fmfi-svt-deadlock/obsolete/README.md

# PROJECT MOVED

This repository is now hosted here: https://gitlab.com/project-deadlock/obsolete/obsolete-embedded-components

Cementery of obsolete components
================================

May they rest in peace.
