fmfi-svt-deadlock/obsolete/reader-hw/reader.brd

## EAGLE design reader-hw/reader.brd (2015-03-18)

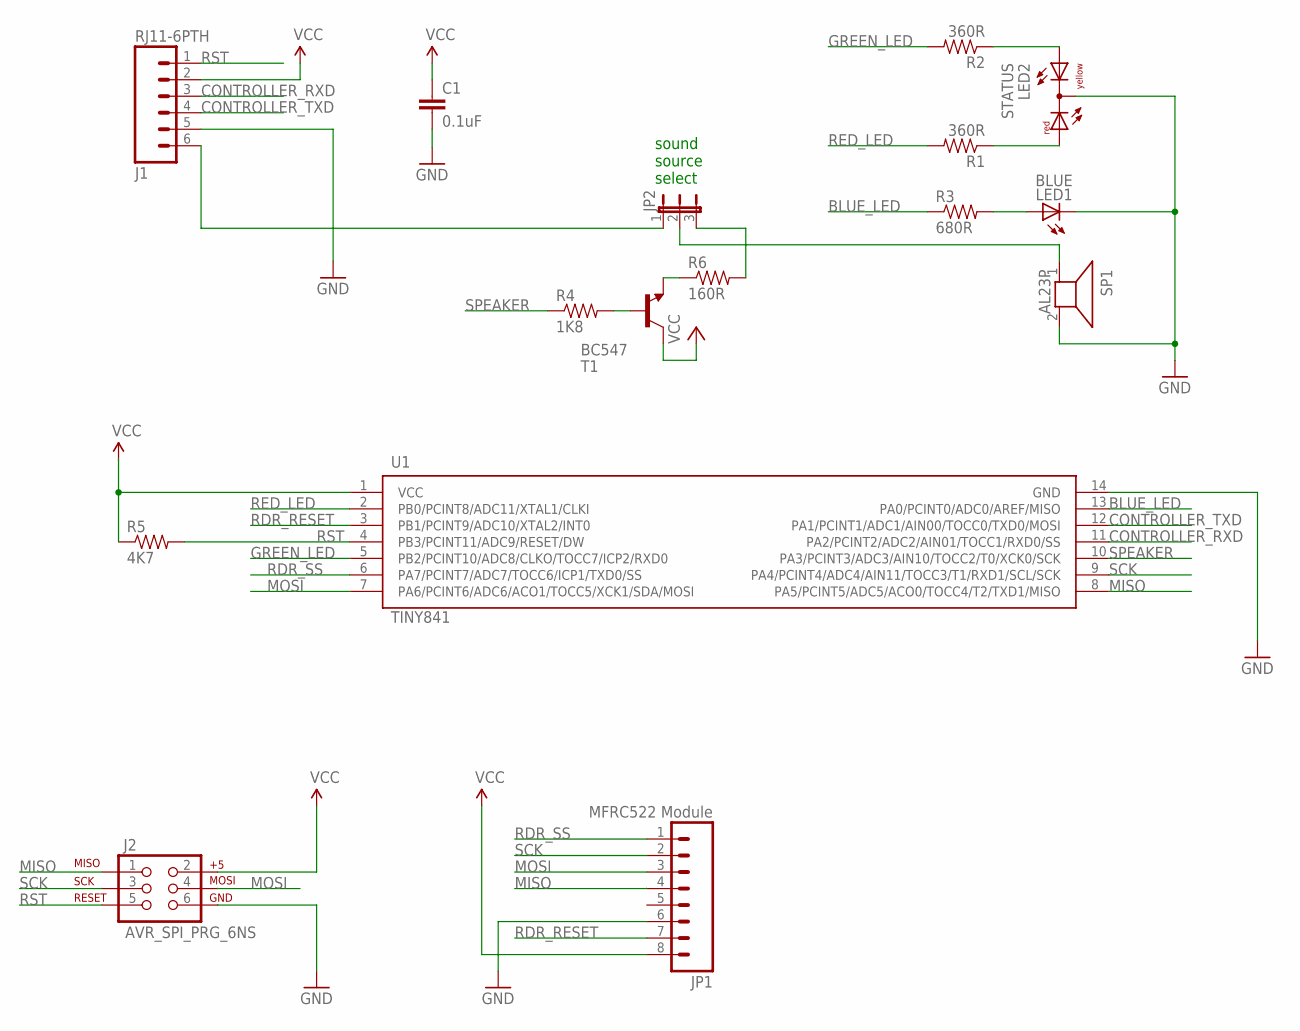
[picture p1: schematic reader.sch]

Parts:
C1: 0.1uF; CAP-PTH-SMALL-KIT
J1: RJ11-6PTH; RJ11-6
J2: AVR_SPI_PRG_6NS; 2X3-NS
JP1: MFRC522 Module; 1X08
JP2: JP2E; JP2
LED1: BLUE; LED3MM
LED2: STATUS; DUOLED-C-5MM
R1, R2: 360R; 0805
R3: 680R; 0805
R4: 1K8; 0805
R5: 4K7; 0805
R6: 160R; 0805
SP1: AL23P
T1: BC547; TO92
U1: TINY841; SO14

Connections:
BLUE_LED: R3.1, U1.13 (PA0/PCINT0/ADC0/AREF/MISO)
CONTROLLER_RXD: J1.3, U1.11 (PA2/PCINT2/ADC2/AIN01/TOCC1/RXD0/SS)
CONTROLLER_TXD: J1.4, U1.12 (PA1/PCINT1/ADC1/AIN00/TOCC0/TXD0/MOSI)
EXT_SPEAKER: J1.6, JP2.1
GND: C1.2, J1.5, J2.6, JP1.6, LED1.K (C), LED2.C, SP1.2, U1.14 (GND)
GREEN_LED: R2.2, U1.5 (PB2/PCINT10/ADC8/CLKO/TOCC7/ICP2/RXD0)
MISO: J2.1, JP1.4, U1.8 (PA5/PCINT5/ADC5/ACO0/TOCC4/T2/TXD1/MISO)
MOSI: J2.4, JP1.3, U1.7 (PA6/PCINT6/ADC6/ACO1/TOCC5/XCK1/SDA/MOSI)
unnamed: JP2.2, SP1.1
unnamed: LED2.AR, R1.1
unnamed: LED2.AX (AY), R2.1
unnamed: R4.2, T1.2 (B)
unnamed: R6.1, T1.1 (E)
unnamed: LED1.A, R3.2
unnamed: JP2.3, R6.2
RDR_RESET: JP1.7, U1.3 (PB1/PCINT9/ADC10/XTAL2/INT0)
RDR_SS: JP1.1, U1.6 (PA7/PCINT7/ADC7/TOCC6/ICP1/TXD0/SS)
RED_LED: R1.2, U1.2 (PB0/PCINT8/ADC11/XTAL1/CLKI)
RST: J1.1, J2.5, R5.2, U1.4 (PB3/PCINT11/ADC9/RESET/DW)
SCK: J2.3, JP1.2, U1.9 (PA4/PCINT4/ADC4/AIN11/TOCC3/T1/RXD1/SCL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)
SPEAKER: R4.1, U1.10 (PA3/PCINT3/ADC3/AIN10/TOCC2/T0/XCK0/SCK)
VCC: C1.1, J1.2, J2.2, JP1.8, R5.1, T1.3 (C), U1.1 (VCC)

Notes on the sheet:
sound source select

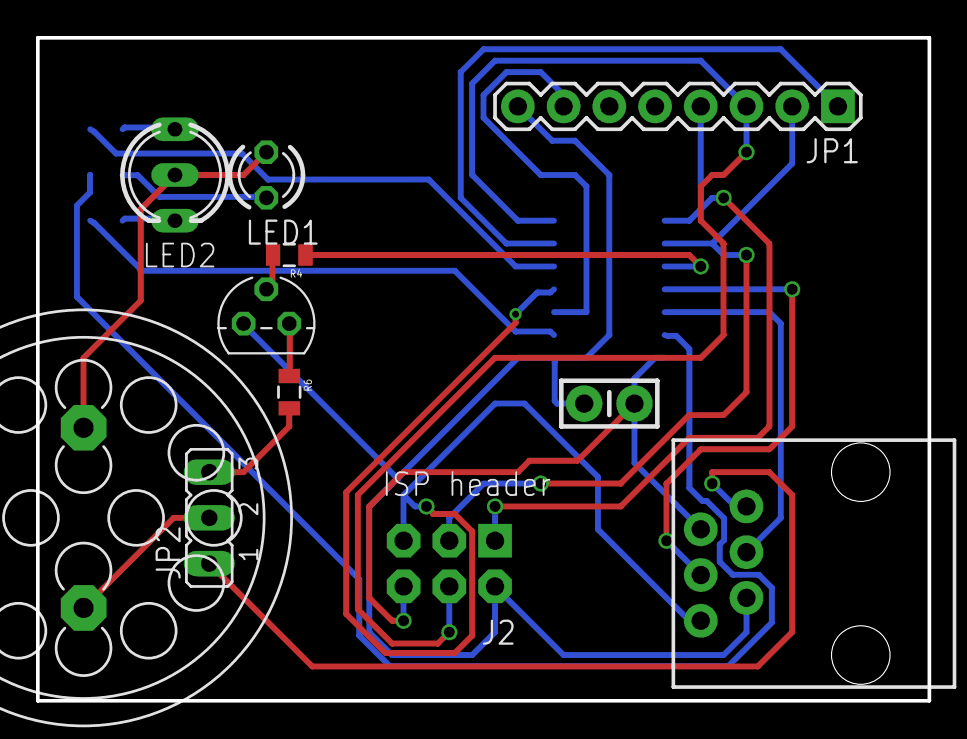
[picture p2: board reader.brd from above]

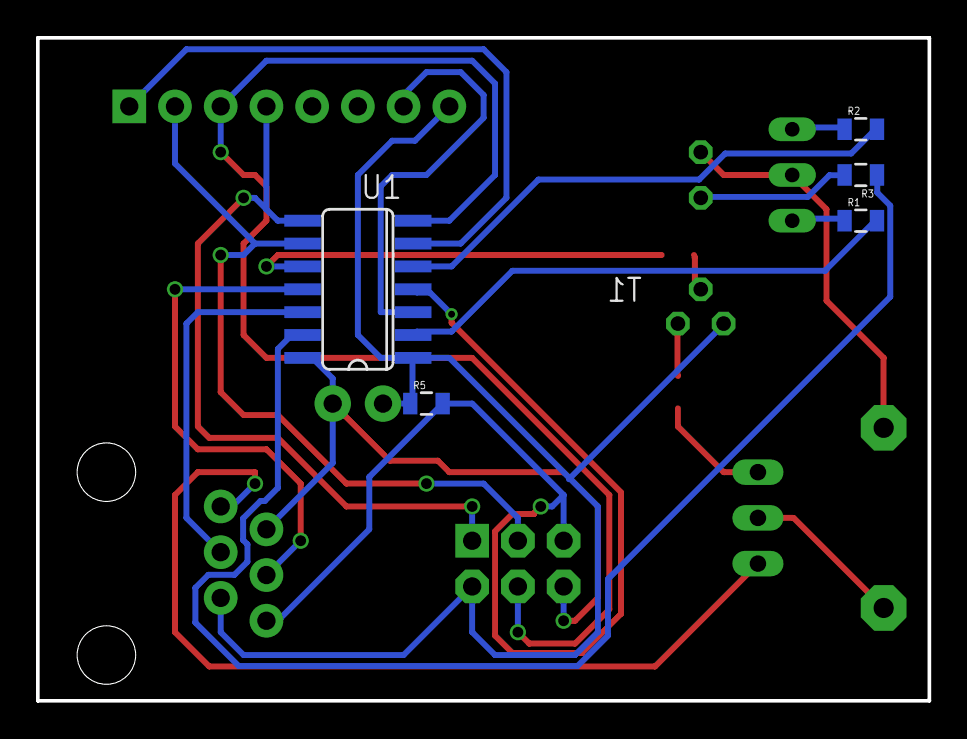
[picture p3: board reader.brd from below]

Board: 2 copper layers, 49.5 x 36.8 mm, 16 parts (5 on the bottom side), 22 nets.
