fmfi-svt-deadlock/obsolete/(commit log)

2015-02-04 Fix indentation in board.h
2015-02-05 Implement HAL for LEDs
2015-02-06 Add recipe for programming fuse bits, change frequency to 8MHz
2015-02-07 Implement SPI HAL
2015-02-07 Fix swapped definitions for RED and GREEN leds
    [hal.h, main.c]
2015-02-08 Change HAL configuration to match the RevB board
2015-02-11 Update Readme - note about the fuses
2015-02-11 Fix newlines, blank spaces and comments
    [hal.h, main.c, spi.c, spkr.c, usart.c]
2015-02-14 [WIP] Implement processing of Status, LED and RFID Tx packets
2015-02-15 [HAL] Add function for stopping current beeping
2015-02-15 [HAL] Implement low-precision timer
2015-02-18 [HAL] Add begin_transaction and end_transaction to SPI HAL
2015-02-26 Clean all connections from the board
    [reader.brd]
2015-02-26 Add a switch transistor to drive the speaker
    [reader.brd, reader.sch]
2015-02-26 Swap SPEAKER and BLUE_LED, reorganize components
    [reader.brd, reader.sch]
2015-02-26 [WIP] Manually route few connectors on the board
    [reader.brd, reader.sch]
2015-02-26 Reroute the board
    [reader.brd, reader.sch]
2015-03-18 Move everything to reader-hw folder
    [reader.brd, reader.sch]
